rajatchaple/pcb_golden_arduino/images/20220410_155442.jpg

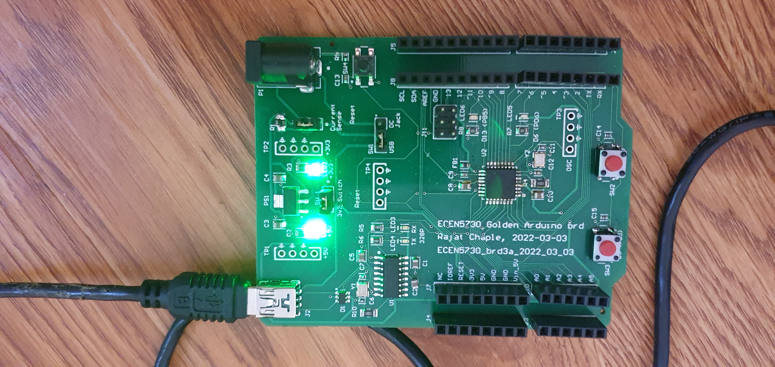
images/20220410_155442.jpg
