rajatchaple/pcb_golden_arduino/images/20220410_151213.jpg

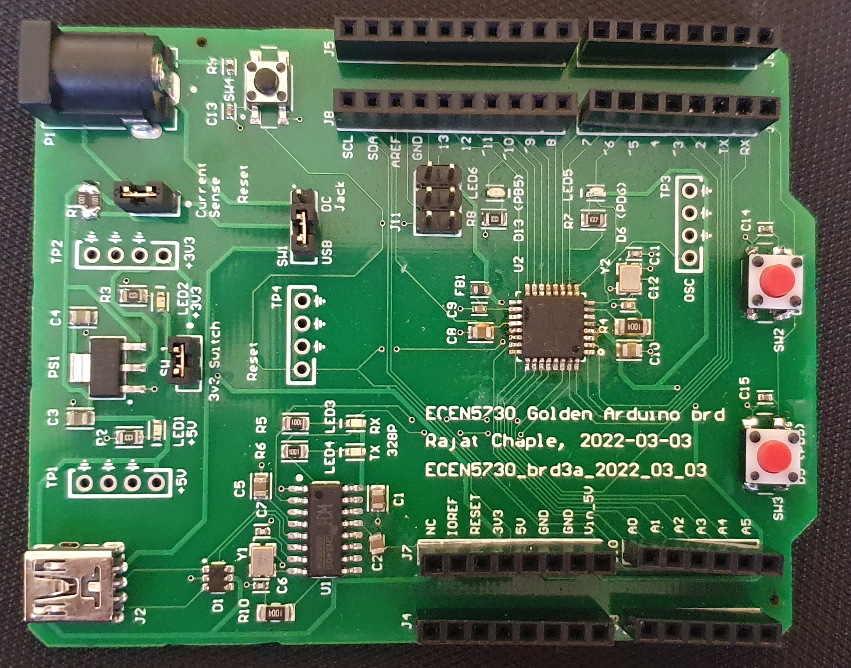
images/20220410_151213.jpg
