rajatchaple/pcb_golden_arduino/images/20220410_151300.jpg

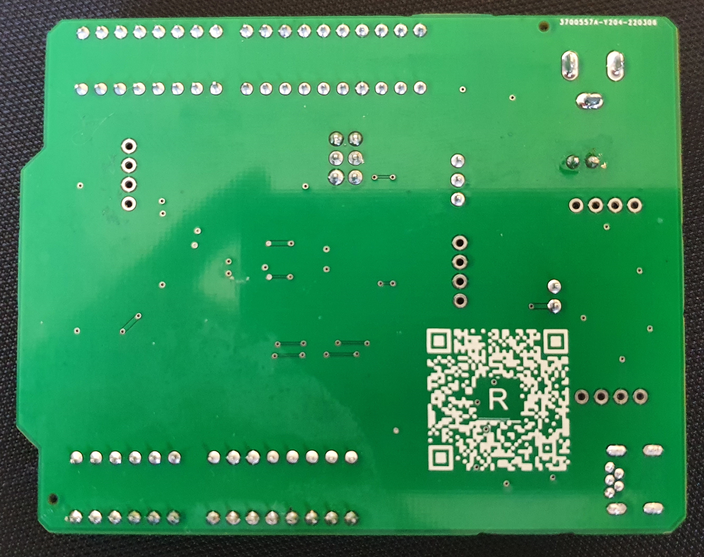
images/20220410_151300.jpg
