rajatchaple/pcb_golden_arduino/images/20220410_154647.jpg

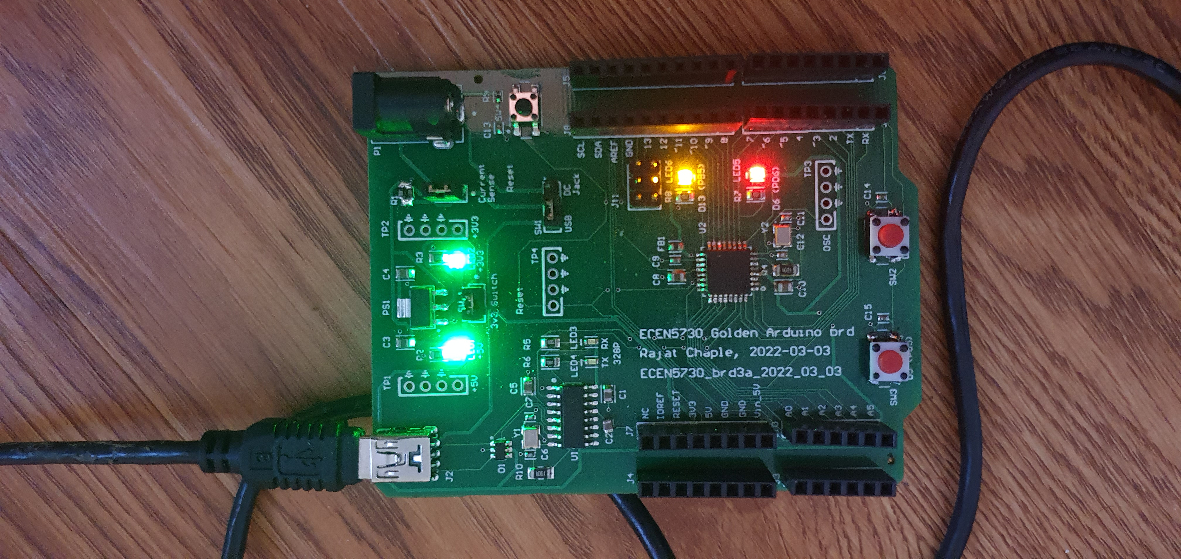
images/20220410_154647.jpg
