rajatchaple/pcb_golden_arduino/images/20220410_184446.jpg

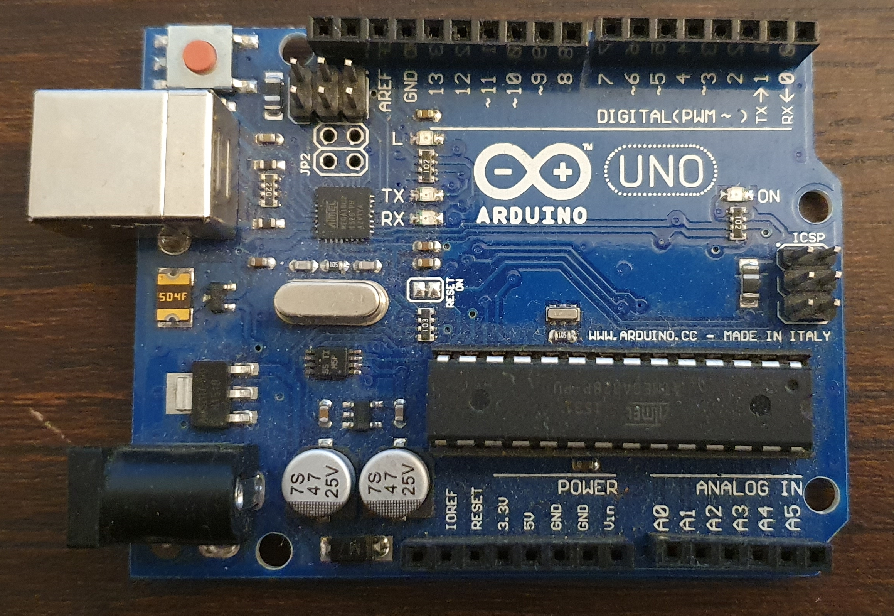
images/20220410_184446.jpg
