rajatchaple/pcb_golden_arduino/images/20220410_235504(0).jpg

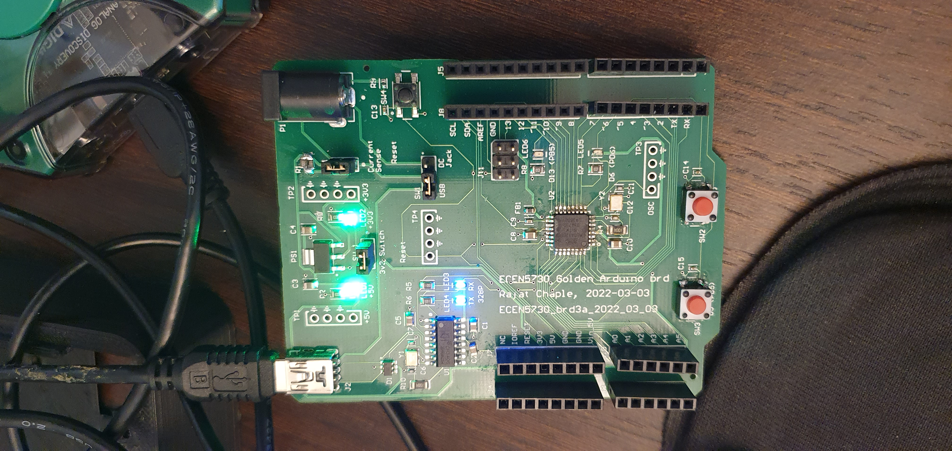
images/20220410_235504(0).jpg
