rajatchaple/pcb_golden_arduino/chaple_bom_golden_arduino_2022_03_03.xlsx

Comment | Description | Designator | Footprint | LibRef | Quantity | LCSC Part#
22uF | MULTILAYER CERAMIC CAPACITORS MLCC - SMD/SMT 22UF 25V 0805 ROHS | C1 | 0805_Passive_Capaciitor | C_22uF_0805 | 1 | C45783
22pF | MULTILAYER CERAMIC CAPACITORS MLCC - SMD/SMT 22PF 50V 0402 ROHS | C2 | 0402_Passive_Capacitor | C_22pF_0402 | 1 | C1555
22uF | MULTILAYER CERAMIC CAPACITORS MLCC - SMD/SMT 22UF 25V 0805 ROHS | C3 | 0805_Passive_Capaciitor | C_22uF_0805 | 1 | C45783
22uF | MULTILAYER CERAMIC CAPACITORS MLCC - SMD/SMT 22UF 25V 0805 ROHS | C4 | 0805_Passive_Capaciitor | C_22uF_0805 | 1 | C45783
22uF | MULTILAYER CERAMIC CAPACITORS MLCC - SMD/SMT 22UF 25V 0805 ROHS | C5 | 0805_Passive_Capaciitor | C_22uF_0805 | 1 | C45783
22pF | MULTILAYER CERAMIC CAPACITORS MLCC - SMD/SMT 22PF 50V 0402 ROHS | C6 | 0402_Passive_Capacitor | C_22pF_0402 | 1 | C1555
22pF | MULTILAYER CERAMIC CAPACITORS MLCC - SMD/SMT 22PF 50V 0402 ROHS | C7 | 0402_Passive_Capacitor | C_22pF_0402 | 1 | C1555
22uF | MULTILAYER CERAMIC CAPACITORS MLCC - SMD/SMT 22UF 25V 0805 ROHS | C8 | 0805_Passive_Capaciitor | C_22uF_0805 | 1 | C45783
10uF | 10uF ±20% 6.3V X5R 0402 Multilayer Ceramic Capacitors MLCC - SMD/SMT RoHS | C9 | 0402_Passive_Capacitor | C_10uF_0402 | 1 | C15525
22uF | MULTILAYER CERAMIC CAPACITORS MLCC - SMD/SMT 22UF 25V 0805 ROHS | C10 | 0805_Passive_Capaciitor | C_22uF_0805 | 1 | C45783
22pF | MULTILAYER CERAMIC CAPACITORS MLCC - SMD/SMT 22PF 50V 0402 ROHS | C11 | 0402_Passive_Capacitor | C_22pF_0402 | 1 | C1555
22pF | MULTILAYER CERAMIC CAPACITORS MLCC - SMD/SMT 22PF 50V 0402 ROHS | C12 | 0402_Passive_Capacitor | C_22pF_0402 | 1 | C1555
1uF | MULTILAYER CERAMIC CAPACITORS MLCC - SMD/SMT 1UF 25V 0402 ROHS | C13 | 0402_Passive_Capacitor | C_1uF_0402 | 1 | C52923
1uF | MULTILAYER CERAMIC CAPACITORS MLCC - SMD/SMT 1UF 25V 0402 ROHS | C14 | 0402_Passive_Capacitor | C_1uF_0402 | 1 | C52923
1uF | MULTILAYER CERAMIC CAPACITORS MLCC - SMD/SMT 1UF 25V 0402 ROHS | C15 | 0402_Passive_Capacitor | C_1uF_0402 | 1 | C52923
SRV05-4-P-T7 | TVS SOT-23-6 ROHS | D1 | TVS | D_TVS_Diode | 1 | C85364
FB_10uH_0603 | 10 uH, 30 Q, 1.85 Ohm Series Resistance, 17MHz Self Resonant Frequency,Inductor , SMD 0603, 3 Amps rated current | FB1 | 0603_PASSIVE_Capacitor | FB_10uH_0603 | 1 | C1035
J_2_PIN_HEADER | 2 Position Header Connector 0.100" (2.54mm) Through Hole Tin | J1 | 2_PIN_100MIL | J_2_PIN_HEADER | 1
USB Mini | Through Hole USB Connectors RoHS | J2 | USB_MINI_B | J_USB_B_Mini | 1 | C46398
PPTC061LFBN-RC | 6 Position Header Connector 0.100" (2.54mm) Through Hole Tin | J3 | 6_PIN_ARDUINO_100mil | JF_6_PIN_FEMALE_ARDUINO | 1 | C40877
PPTC081LFBN-RC | 8 Position Header Connector 0.100" (2.54mm) Through Hole Tin | J4 | 8_PIN_ARDUINO_100MIL | JF_8_PIN_FEMALE_ARDUINO | 1 | C27438
PPTC101LFBN-RC | 10 Position Header Connector 0.100" (2.54mm) Through Hole Tin | J5 | 10_PIN_ARDUINO_100MIL | JF_10_PIN_FEMALE_ARDUINO | 1 | C225507
PPTC081LFBN-RC | 8 Position Header Connector 0.100" (2.54mm) Through Hole Tin | J6 | 8_PIN_ARDUINO_100MIL | JF_8_PIN_FEMALE_ARDUINO | 1 | C27438
PPTC081LFBN-RC | 8 Position Header Connector 0.100" (2.54mm) Through Hole Tin | J7 | 8_PIN_ARDUINO_100MIL | JF_8_PIN_FEMALE_ARDUINO | 1 | C27438
PPTC101LFBN-RC | 10 Position Header Connector 0.100" (2.54mm) Through Hole Tin | J8 | 10_PIN_ARDUINO_100MIL | JF_10_PIN_FEMALE_ARDUINO | 1 | C225507
PPTC081LFBN-RC | 8 Position Header Connector 0.100" (2.54mm) Through Hole Tin | J9 | 8_PIN_ARDUINO_100MIL | JF_8_PIN_FEMALE_ARDUINO | 1 | C27438
PPTC061LFBN-RC | 6 Position Header Connector 0.100" (2.54mm) Through Hole Tin | J10 | 6_PIN_ARDUINO_100mil | JF_6_PIN_FEMALE_ARDUINO | 1 | C40877
NRPN032PAEN-RC | Connector Header Through Hole 6 position 0.079" (2.00mm) | J11 | ICSP | J_ICSP | 1 | C124384
KT-0603R | LIGHT EMITTING DIODES (LED) GREEN 520~535NM 112~258MCD@20MA TOP VIEW 0603 ROHS | LED1 | LED_0603 | LED_GREEN_0603 | 1 | C72043
KT-0603R | LIGHT EMITTING DIODES (LED) GREEN 520~535NM 112~258MCD@20MA TOP VIEW 0603 ROHS | LED2 | LED_0603 | LED_GREEN_0603 | 1 | C72043
KT-0603R | LIGHT EMITTING DIODES (LED) BLUE 465~475NM 11.5~28.5MCD@5MA TOP VIEW 0603 ROHS | LED3 | LED_0603 | LED_BLUE_0603 | 1 | C72041
KT-0603R | LIGHT EMITTING DIODES (LED) BLUE 465~475NM 11.5~28.5MCD@5MA TOP VIEW 0603 ROHS | LED4 | LED_0603 | LED_BLUE_0603 | 1 | C72041
KT-0603R | LIGHT EMITTING DIODES (LED) RED 520~625NM 90~100MCD@20MA TOP VIEW 0603 ROHS | LED5 | LED_0603 | LED_RED_0603 | 1 | C2286
KT-0603R | LIGHT EMITTING DIODES (LED) YELLOW 585.5~591.5NM 90~180MCD@20MA TOP VIEW 0603 ROHS | LED6 | LED_0603 | LED_YELLOW_0603 | 1 | C72038
Power Jack | Power Barrel Connector Jack 2.10mm ID (0.083"), 5.50mm OD (0.217") Through Hole, Right Angle | P1 | Power_Jack | P_Power Jack | 1 | C136744
AMS1117-3.3 | LOW DROPOUT REGULATORS(LDO) POSITIVE FIXED 1.3V @ 800MA 15V 3.3V 1A SOT-223 ROHS | PS1 | LDO | PS_AMS_LDO_3v3 | 1 | C6186
500m | CHIP RESISTOR - SURFACE MOUNT 10.5OHMS ±1% 1/4W 1206 ROHS | R1 | 1206_Passive_Resitor | R_500m_1206 | 1
1k | CHIP RESISTOR - SURFACE MOUNT 1KOHMS ±1% 1/8W 0805 ROHS | R2 | 0805_Passive_Resistor | R_1K_0805 | 1 | C17513
1k | CHIP RESISTOR - SURFACE MOUNT 1KOHMS ±1% 1/8W 0805 ROHS | R3 | 0805_Passive_Resistor | R_1K_0805 | 1 | C17513
1M | CHIP RESISTOR - SURFACE MOUNT 1MOHMS ±1% 1/4W 1206 ROHS | R4 | 1206_Passive_Resitor | R_1M_1206 | 1 | C17927
1k | CHIP RESISTOR - SURFACE MOUNT 1KOHMS ±1% 1/8W 0805 ROHS | R5 | 0805_Passive_Resistor | R_1K_0805 | 1 | C17513
1k | CHIP RESISTOR - SURFACE MOUNT 1KOHMS ±1% 1/8W 0805 ROHS | R6 | 0805_Passive_Resistor | R_1K_0805 | 1 | C17513
1k | CHIP RESISTOR - SURFACE MOUNT 1KOHMS ±1% 1/8W 0805 ROHS | R7 | 0805_Passive_Resistor | R_1K_0805 | 1 | C17513
1k | CHIP RESISTOR - SURFACE MOUNT 1KOHMS ±1% 1/8W 0805 ROHS | R8 | 0805_Passive_Resistor | R_1K_0805 | 1 | C17513
10k | CHIP RESISTOR - SURFACE MOUNT 10KOHMS ±1% 1/16W 0402 ROHS | R9 | 0402_Passive_Resistor | R_10KOhm_0402 | 1 | C25744
1M | CHIP RESISTOR - SURFACE MOUNT 1MOHMS ±1% 1/4W 1206 ROHS | R10 | 1206_Passive_Resitor | R_1M_1206 | 1 | C17927
PREC003SAAN-RC | Connector Header Through Hole 3 position 0.100" (2.54mm) | SW1 | 3_PIN_100mil | SW_3Pin_100mil_Switch | 1 | C429954
TL3305AF160QG | Tactile Switch SPST-NO Top Actuated Surface Mount | SW2 | Switch_JLC | SW_Push_Button_JLC | 1 | C174049
TL3305AF160QG | Tactile Switch SPST-NO Top Actuated Surface Mount | SW3 | Switch_JLC | SW_Push_Button_JLC | 1 | C174049
TL3305AF160QG | Tactile Switch SPST-NO Top Actuated Surface Mount | SW4 | Switch_JLC | SW_Push_Button_JLC | 1 | C174049
SW_2Pin_100mil_Switch | 2Pin Header | SW_1 | 2Pin-Header-Conn | SW_2Pin_100mil_Switch | 1 | C124375
TP_5V | Test Point 300 mil centers | TP1 | TP10x_Probe | TP_10x_Probe | 1
TP_3v3 | Test Point 300 mil centers | TP2 | TP10x_Probe | TP_10x_Probe | 1
OSC16 | Test Point 300 mil centers | TP3 | TP10x_Probe | TP_10x_Probe | 1
RST | Test Point 300 mil centers | TP4 | TP10x_Probe | TP_10x_Probe | 1
CH340G | Transceiver USB 2.0 2Mbps SOP-16_150mil USB ICs RoHS | U1 | USB to serial | U_USBtoSerial | 1 | C14267
ATMEGA328P-ANR | AVR AVR® ATmega Microcontroller IC 8-Bit 20MHz 32KB (16K x 16) FLASH 32-TQFP (7x7) | U2 | ATMega328P | U_ATMega328P | 1 | C14877
X322512MSB4SI | SMD Crystal Resonators 12MHz ±10ppm SMD-3225_4P RoHS | Y1 | Crystal resonator | X_12MHz_Res | 1 | C9002
X322516MLB4SI | ±10ppm 16000000Hz -40℃~85℃ 贴片无源晶振 60Ω 9pF SMD3225-4P Crystals ROHS | Y2 | Crystal resonator | X_16Mhz_Res | 1 | C13738
