rajatchaple/pcb_golden_arduino/(list of files, drawings)

Other design files:
golden_arduino.PcbDoc
golden_arduino.PrjPcb
golden_arduino.SchDoc
